mkvesala/VEDirect-ESP32-SignalK-gateway/README.md

# VEDirect-ESP32-SignalK Gateway








## Disclaimer

This is a personal hobby project. It is provided "as is", without warranty of any kind. See LICENSE.

This firmware is NOT intended for navigation or for any safety-critical use at sea. Do not rely on the data it produces (such as heading, depth or position) to navigate a vessel. Always use certified navigation equipment and proper seamanship.

You use this code entirely at your own risk. The author accepts no liability for any damage, injury or loss arising from its use.

## Introduction

ESP32-based gateway that reads battery data from a [Victron SmartShunt](https://www.victronenergy.com/battery-monitors/smart-battery-shunt) via the VE.Direct text protocol and forwards it to a [SignalK](https://signalk.org) server via WebSocket/JSON and to other ESP32 devices via ESP-NOW.

Reads five values from the SmartShunt: house battery voltage, current and power, state of charge, and starter battery voltage. Converts raw VE.Direct integers to SI units (V, A, W, SoC as percent) and sends all five values in a single SignalK delta every second.

Uses LCD 16x2 to show battery status, performance diagnostics and network connection info. If no Wi-Fi is available, ESP-NOW broadcast continues and the LCD shows battery data.

OTA updates enabled. Persistent configuration storage (NVS) and web UI reserved for future implementations.

Developed and tested on:
- [Wemos D1 R32 ESP32 development board](https://partco.fi/tuote/arduino-esp32-kehityskortti-esp-wroom-32-2526)
- [ESP32 board package](https://github.com/espressif/arduino-esp32) (3.3.8)
- [Arduino IDE](https://www.arduino.cc/en/software/) (2.3.8)
- SignalK Server (2.26.0)
- Victron SmartShunt (300 A)

Integrated via ESP-NOW to:
- [ESP32-Crowpanel-compass multi-function display](https://github.com/mkvesala/ESP32-Crowpanel-compass) v4.0.0

## Purpose of the project

This is one of my individual digital boat projects. Use at your own risk. Not for safety-critical operations.

1. I wanted a cost-effective way to get Victron battery monitor data wirelessly into SignalK without the official Victron dongle
2. I needed ESP-NOW output so a standalone display can show battery status without depending on the SignalK network being up
3. The project started as a single-file Arduino sketch and was later refactored into the class-based architecture I have used in my other "gateway" projects

## Release history

| Release | Branch | Comment |
|---|---|---|
| v1.2.4 | main | WiFi outage recovery: the radio stays on, so ESP-NOW keeps broadcasting while the router is down, and WiFi and SignalK reconnect by themselves. See CHANGELOG. |
| v1.2.3 | main | Shared `espnow_protocol.h` synced with the fleet-wide copy — adds `HALMET_OIL_DELTA` (10) and its `HALMETOilDelta` payload struct. Wire format of this gateway unchanged. |
| v1.2.2 | main | Documentation only — Disclaimer section added to README, fleet-wide `espnow_protocol.h` paragraph removed. |
| v1.2.1 | main | Shared `espnow_protocol.h` updated to the fleet-wide superset — adds `HALMET_WATER_DELTA` (7) and `DEPTH_DELTA` (8) with their payload structs, documents the shared-header rules and `msg_type` allocation, and fixes receiver-side GNSS conversion that hid position and SOG at anchor. Wire format of this gateway unchanged. |
| v1.2.0 | main | `SignalKBroker` owns the `WebsocketsClient` via `std::unique_ptr` and builds a fresh client on every reconnect — fixes a rare permanent WebSocket reconnect failure after long uptime where a stuck lwIP socket was reused indefinitely. |
| v1.1.0 | main | AP interface secured (hidden SSID, WPA2, intrusion detection). Wi-Fi timeout extended to 3 min, static IP support and hardened reconnect/recovery added. Active WebSocket ping/pong liveness with graceful transport-only reconnect. GNSS structs added to shared ESP-NOW protocol. |
| v1.0.0 | main | First versioned release. Full refactor into class-based architecture. ESP-NOW added. |

## Classes

Class diagram including the companion projects:



### VEDSensor

Encapsulates VE.Direct serial communication. Runs a FreeRTOS reader task pinned to Core 0 that continuously reads the UART stream and populates an internal cache protected by `portMUX_TYPE` spinlock. The main loop reads a consistent snapshot via `getSnapshot()` without blocking.

| Method | Returns | Comment |
|---|---|---|
| `begin()` | `void` | Configures UART2 (RX GPIO16, 19200 baud) and starts reader task. |
| `getSnapshot(Snapshot &out)` | `void` | Thread-safe atomic copy of the current cache. |
| `getReaderStackWatermark()` | `uint32_t` | Get stack high watermark of reader task. |

`VEDSensor::Snapshot` fields: `mv`, `ma`, `w`, `soc`, `vs` (raw int32) and matching millisecond timestamps `ts_mv` … `ts_vs`.

### VEDProcessor

Consumes a `VEDSensor::Snapshot`, converts raw VE.Direct integers to SI units, and populates the shared `ESPNow::BatteryDelta` struct. A value is set to `NaN` if its timestamp is older than 30 seconds.

| Method | Returns | Comment |
|---|---|---|
| `update()` | `void` | Reads snapshot, converts, updates delta and getters |
| `getDelta()` | `ESPNow::BatteryDelta` | All five SI values for brokers |
| `getHouseVoltage()` | `float` | House bank volts (V) |
| `getHouseCurrent()` | `float` | House bank amps (A) |
| `getHousePower()` | `float` | House bank watts (W) |
| `getHouseSoc()` | `float` | House bank state of charge (% 0.0-100.0) |
| `getStartVoltage()` | `float` | Starter battery volts (V) |
| `hasValidData()` | `bool` | True if at least one value is not NaN |

### Other classes

**`SignalKBroker`:**
- Owns: `WebsocketsClient` via `std::unique_ptr` — a fresh client is built on every reconnect and destroyed on teardown, so no stuck lwIP socket survives to the next attempt
- Uses: `VEDProcessor`
- Owned by: `VEDApplication`
- Responsible for: WebSocket connection to SignalK server, building and sending a single JSON delta containing all five battery values every ~1 s

**`ESPNowBroker`:**
- Uses: `VEDProcessor`
- Owned by: `VEDApplication`
- Responsible for: ESP-NOW broadcast of `ESPNowPacket<BatteryDelta>` every ~1 s using the shared `espnow_protocol.h` packet format

**`DisplayManager`:**
- Owns: two `LiquidCrystal_I2C` instances (addresses 0x27 and 0x3F), selected by I2C scan on boot
- Uses: `VEDProcessor`
- Owned by: `VEDApplication`
- Responsible for: LCD display of battery data, diagnostics and status messages

**`VEDPreferences`:**
- Uses: `VEDProcessor`
- Owned by: `VEDApplication`
- Responsible for: NVS configuration storage — *skeleton, not yet implemented*

**`WebUIManager`:**
- Uses: `VEDProcessor`, `VEDPreferences`, `SignalKBroker`, `DisplayManager`
- Owned by: `VEDApplication`
- Responsible for: HTTP configuration UI — *skeleton, not yet implemented*

**`VEDApplication`:**
- Owns: all subsystems as stack-allocated members
- Uses: `WifiState`
- Responsible for: orchestrating all subsystems, running the Wi-Fi state machine and timed loop handlers, AP interface security (hidden SSID, WPA2, intrusion detection and deauth)

**`WifiState`:**
- Global enum class for Wi-Fi connection states (INIT / CONNECTING / CONNECTED / FAILED / DISCONNECTED / OFF) just to lessen the amount of calls to WiFi library and to keep WiFi dependency only in `VEDApplication`

## Features

### VE.Direct reading

1. Reads the continuous VE.Direct text stream on UART2 (RX GPIO16, 19200 baud, SERIAL_8N1)
2. Reader runs in a dedicated FreeRTOS task on Core 0 at priority 2, independent of the main loop
3. Parsed label→value pairs are cached with millisecond timestamps; five labels tracked: `V`, `I`, `P`, `SOC`, `VS`
4. Cache access is protected by `portMUX_TYPE` spinlock's critical section; main loop reads via atomic `getSnapshot()`
5. Values older than 30 seconds are treated as stale and reported as `NaN`
6. Raw integers converted to SI units in `VEDProcessor`: mV→V, mA→A, Victron SoC tenths-of-percent→percent (0.0-100.0)

### SignalK communication

Connects to:
```
ws://<server>:<port>/signalk/v1/stream?token=<optional>
```

**Sends** at ~1 s interval, all five values in a single delta message:

1. `electrical.batteries.house.voltage` (V)
2. `electrical.batteries.house.current` (A)
3. `electrical.batteries.house.power` (W)
4. `electrical.batteries.house.capacity.stateOfCharge` (0.0-1.0)
5. `electrical.batteries.start.voltage` (V)

Values that are `NaN` (stale or not yet received) are silently omitted from the delta. If all five are `NaN` the delta is not sent.

WebSocket reconnection uses exponential backoff starting at ~2 s, doubling on each failed attempt up to a maximum of ~120 s. On successful reconnect the backoff resets to ~2 s. Each reconnect builds a **brand-new** WebSocket client (`SignalKBroker` owns it via `std::unique_ptr`) and destroys it on teardown, so a socket that has stuck in an unrecoverable state is never reused — freeing the underlying lwIP socket guarantees every attempt starts from a clean transport. This prevents a rare permanent reconnect failure observed after long uptime (~12–48 h) where a reused client could no longer connect until a manual reboot.

**Connection liveness (active ping/pong):** while the socket is open the device sends a WebSocket ping every ~10 s and tracks the server's pong. If no pong arrives within ~30 s the connection is considered dead — even when `isOpen()` still reports `true`, as happens with a half-open TCP connection (e.g. the SignalK host freezing the link under power-saving) — and the socket is closed so the exponential back-off reconnects it. Recovery is transport-only: the device does **not** reboot, so ESP-NOW, the LCD and uptime are unaffected.

Each Wi-Fi connection attempt lasts up to ~15 s. If it fails, the device keeps running with ESP-NOW only and retries every ~30 s–2 min (exponential back-off) until the network returns; SignalK and OTA resume without a reboot. The radio is never switched off, and while waiting it is held on ESP-NOW channel 6.

The device connects with a static IP address configured via `WiFi.config()` from `WIFI_STATIC_IP` / `WIFI_GATEWAY` / `WIFI_SUBNET` in `secrets.h`, rather than relying on the router's DHCP lease table — keep the chosen address outside the router's DHCP pool. If Wi-Fi drops, the connection is rebuilt with a hard reset (`WiFi.disconnect(true)` + reapplied static IP and sleep settings) and the SignalK WebSocket is reopened automatically.

**Please refer to Security section of this file.**

### ESP-NOW communication

Broadcasts battery data via ESP-NOW protocol for other ESP32 devices such as external displays. Operates independently of Wi-Fi — broadcast continues even if SignalK connection is lost.

All ESP-NOW messages use the shared `ESPNow::ESPNowPacket` wrapper (`ESPNowHeader` + typed payload) defined in `espnow_protocol.h`.

**Sends** at ~1 s interval:
- `ESPNow::ESPNowPacket<BatteryDelta>` — payload `BatteryDelta` containing:
  - `house_voltage` (V)
  - `house_current` (A)
  - `house_power` (W)
  - `house_soc` (% 0.0-100.0)
  - `start_voltage` (V)

**Broadcast mode:** Uses broadcast address (FF:FF:FF:FF:FF:FF) — any ESP-NOW receiver on the same Wi-Fi channel can listen.

**WiFi coexistence:** ESP-NOW operates alongside Wi-Fi (`WIFI_AP_STA` mode). Both SignalK WebSocket and ESP-NOW broadcast function simultaneously. The AP interface required by `WIFI_AP_STA` is secured — see Security section.

**Note: ESP-NOW receivers must be on the same Wi-Fi channel as this device. The simplest approach is to connect both devices to the same Wi-Fi network with a fixed channel.**

### LCD 16x2

1. Shows house voltage, starter voltage, house current and state of charge in a compact two-line layout:
   ```
    26.54V  26.71V
    -3.20A  87.5%
   ```
2. Shows status messages during boot (Wi-Fi connecting, IP address, signal level) and periodically during operation (Wi-Fi signal level, WebSocket open/closed)
3. Shows diagnostic messages on the way (free heap mem, stack high watermark for reader task and main loop)
4. LCD content refreshes only when it has changed, to avoid unnecessary blinking
5. Supports both I2C addresses 0x27 and 0x3F — detected automatically on boot
6. If no LCD is detected the device operates normally without display output

Using a different display can be done within `DisplayManager` while keeping its public API intact.

## Project structure

| File(s) | Description |
|---|---|
| `VEDirect-ESP32-SignalK-gateway.ino` | Owns `VEDApplication app`, contains `setup()` and `loop()` |
| `secrets.example.h` | Example credentials. Rename to `secrets.h` and populate with your credentials |
| `version.h` | Software version constant |
| `helpers.h` | Global helper functions |
| `espnow_protocol.h` | Shared ESP-NOW protocol definitions (header, payload structs, packet wrapper) — fleet-wide superset, kept byte-identical in every project |
| `WifiState.h` | Enum class for Wi-Fi states |
| `VEDSensor.h / .cpp` | Class `VEDSensor` — VE.Direct UART reader, FreeRTOS task, thread-safe cache |
| `VEDProcessor.h / .cpp` | Class `VEDProcessor` — unit conversion and `BatteryDelta` assembly |
| `VEDPreferences.h / .cpp` | Class `VEDPreferences` — NVS storage skeleton |
| `SignalKBroker.h / .cpp` | Class `SignalKBroker` — WebSocket connection and delta sender |
| `ESPNowBroker.h / .cpp` | Class `ESPNowBroker` — ESP-NOW broadcast sender |
| `DisplayManager.h / .cpp` | Class `DisplayManager` — LCD 16x2 I2C control |
| `WebUIManager.h / .cpp` | Class `WebUIManager` — HTTP web UI skeleton |
| `VEDApplication.h / .cpp` | Class `VEDApplication` — application orchestrator |

## Hardware

### Bill of materials

1. Wemos D1 R32 ESP32 Dev Module
2. Victron SmartShunt with VE.Direct port
3. LCD 16x2 module with I2C backpack
4. Wi-Fi router providing wireless LAN AP with a fixed channel
5. 3D printed [panel mount bezel](https://www.printables.com/model/158413-panel-mount-16x2-lcd-bezel) for LCD 16x2
6. Wiring, DC power jack, enclosure
7. MacOS device running SignalK server in LAN
8. Crowpanel 2.1" HMI rotary display running Crowpanel-ESP32-compass firmware

### Wiring

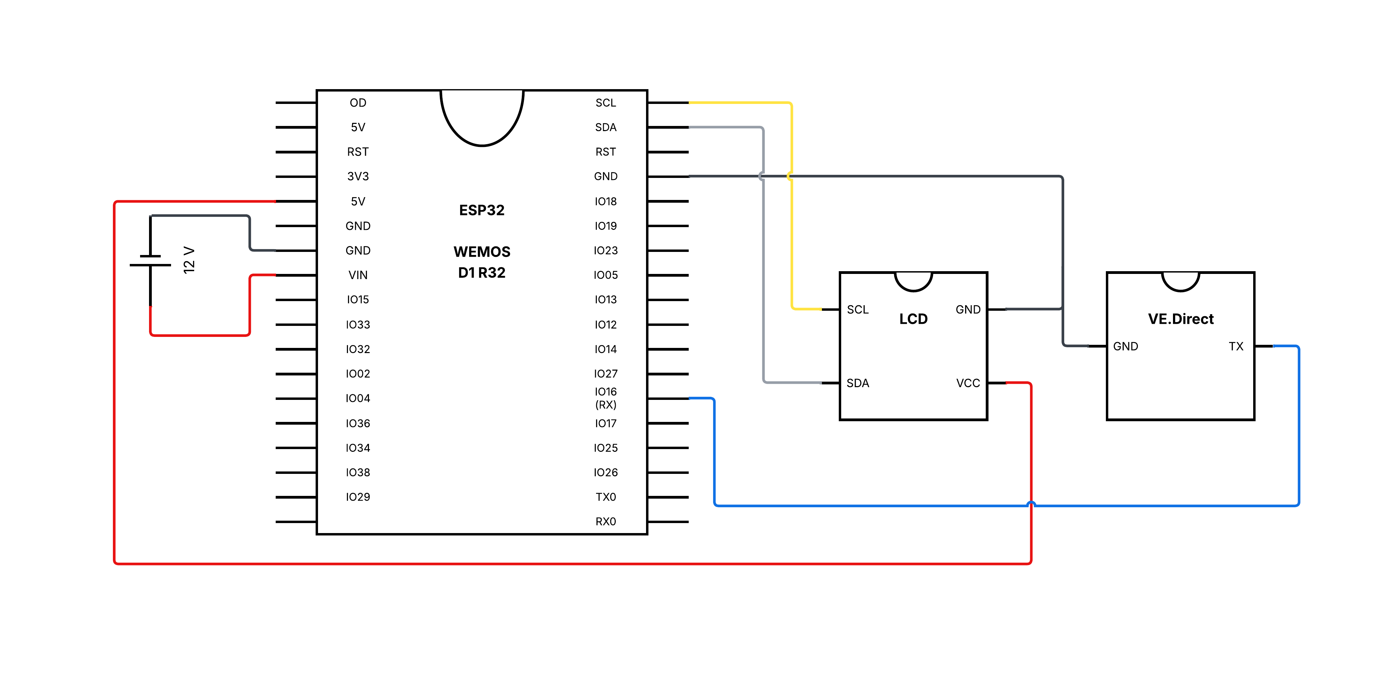
[picture p1: docs/vedschema.png]


**Note: Victron SmartShunt versions use both 3.3 V and 5 V TTL levels at VE.Direct port — ALWAYS measure the level before connecting to ESP32 board and use logic level shifter if needed!**

**No paid partnerships.**

## Software used

1. Arduino IDE 2.3.8
2. Espressif Systems esp32 board package 3.3.8
3. Additional libraries installed via Library Manager:
   - ArduinoWebsockets by Gil Maimon (0.5.4)
   - ArduinoJson by Benoit Blanchon (7.4.3)
   - LiquidCrystal_I2C by Frank de Brabander (1.1.2)
   - ArduinoOTA (included in ESP32 board package)
4. Crowpanel-ESP32-compass firmware (v4.0.0)
5. SignalK server (2.26.0)

## Installation

1. Clone the repo
   ```
   git clone https://github.com/mkvesala/VEDirect-ESP32-SignalK-gateway.git
   ```
2. Alternatively, download the code as a zip
3. Set up your credentials in `secrets.h` (first by renaming `secrets.example.h` to `secrets.h`)
   ```cpp
   inline constexpr const char* WIFI_SSID            = "your_wifi_ssid_here";
   inline constexpr const char* WIFI_PASS            = "your_wifi_password_here";
   inline constexpr const char* WIFI_STATIC_IP       = "192.168.1.50";   // keep outside the router's DHCP pool
   inline constexpr const char* WIFI_GATEWAY         = "192.168.1.1";
   inline constexpr const char* WIFI_SUBNET          = "255.255.255.0";
   inline constexpr const char* SK_HOST              = "your_signalk_address_here";
   inline constexpr uint16_t    SK_PORT              = 3000; // or whatever your port is
   inline constexpr const char* SK_TOKEN             = "your_token_here";
   inline constexpr const char* OTA_PASS             = "your_ota_password_here";
   inline constexpr const char* DEFAULT_WEB_PASSWORD = "your_default_web_password_here";
   inline constexpr const char* AP_SSID              = "your_ap_ssid_here";    // hidden, name not critical
   inline constexpr const char* AP_PASS              = "your_ap_password_here"; // min 8 chars (WPA2)
   ```
4. **Make sure that `secrets.h` is listed in your `.gitignore` file**
5. Connect the SmartShunt VE.Direct TX to GPIO16 (RX) and optionally an LCD to the I2C pins
6. Connect and power up the ESP32 via USB
7. Compile and upload with Arduino IDE (board package and required libraries installed)
8. Open Serial Monitor at 115200 baud to verify the device is reading VE.Direct data and connecting to Wi-Fi
9. Verify battery values appear in the SignalK server data browser

**Please refer to Security section of this file.**

## Todo

Check [issues](https://github.com/mkvesala/VEDirect-ESP32-SignalK-gateway/issues).

## Security

### Maritime navigation

**Use at your own risk — not for safety-critical operations!**

### Current state

The web UI is not yet implemented — there are no HTTP endpoints exposed. The device only opens an outbound WebSocket connection to the SignalK server and sends ESP-NOW broadcasts.

### AP interface

`WIFI_AP_STA` mode is required for ESP-NOW and Wi-Fi to operate simultaneously. This opens an AP interface on the ESP32 that is not intended for external connections. It is hardened with three lines of defence:

| Line | Mechanism |
|---|---|
| **1. Hidden SSID** | `ssid_hidden=1` — the network is not advertised |
| **2. WPA2 password** | `AP_PASS` from `secrets.h` (min 8 characters) — connection is blocked without the password |
| **3. Immediate deauth + alert** | If a client connects despite the above, it is kicked immediately via `esp_wifi_deauth_sta()` in the WiFi event callback. The MAC address is logged to Serial and shown on the LCD. |

Set `AP_SSID` and `AP_PASS` in `secrets.h`. The SSID name is not critical since it is hidden — use something non-identifying. The password must be at least 8 characters (WPA2 requirement).

### SignalK token

If your SignalK server requires authentication, provide the token in `secrets.h`. The token is transmitted in the WebSocket URL in plaintext over the local network.

### Important security considerations

1. **No HTTPS**
   - WebSocket connection transmits data in plaintext
   - Use only on private, trusted networks

2. **LAN deployment only**
   - Do NOT expose the device to the public internet
   - Keep the ESP32 on an isolated boat Wi-Fi network
   - Use WPA2/WPA3 encryption

3. **`secrets.h`**
   - Make sure that `secrets.h` is listed in your `.gitignore` file
   - Never commit credentials to version control

### Deployment

**Recommended:**
- Deploy on a private isolated boat Wi-Fi
- Use WPA2/WPA3 Wi-Fi encryption

**Not recommended:**
- Public internet exposure
- Port forwarding to the ESP32

## Credits

Software and libraries used are described in the above sections.

Inspired by [VictronVEDirectArduino](https://github.com/winginitau/VictronVEDirectArduino) library.

This project started as a single-file `.ino` sketch and was refactored into the class-based architecture, which also serves as the architectural reference for [CMPS14-ESP32-SignalK-gateway](https://github.com/mkvesala/CMPS14-ESP32-SignalK-gateway), [UBLOX-ESP32-SignalK-gateway](https://github.com/mkvesala/UBLOX-ESP32-SignalK-gateway), [HALMET-ESP32-SignalK-gateway](https://github.com/mkvesala/HALMET-ESP32-SignalK-gateway) and [BME280-ESP32-SignalK-gateway](https://github.com/mkvesala/BME280-ESP32-SignalK-gateway). This is a companion project also to the [ESP32-Crowpanel-compass](https://github.com/mkvesala/ESP32-Crowpanel-compass). See below diagram how the projects relate:



No paid partnerships.

Developed by Matti Vesala in collaboration with Claude Code. See [CONTRIBUTING](CONTRIBUTING.md) for guidelines on development.

I would appreciate improvement suggestions as well as any Arduino-style ESP32/C++ coding advice.

## Gallery

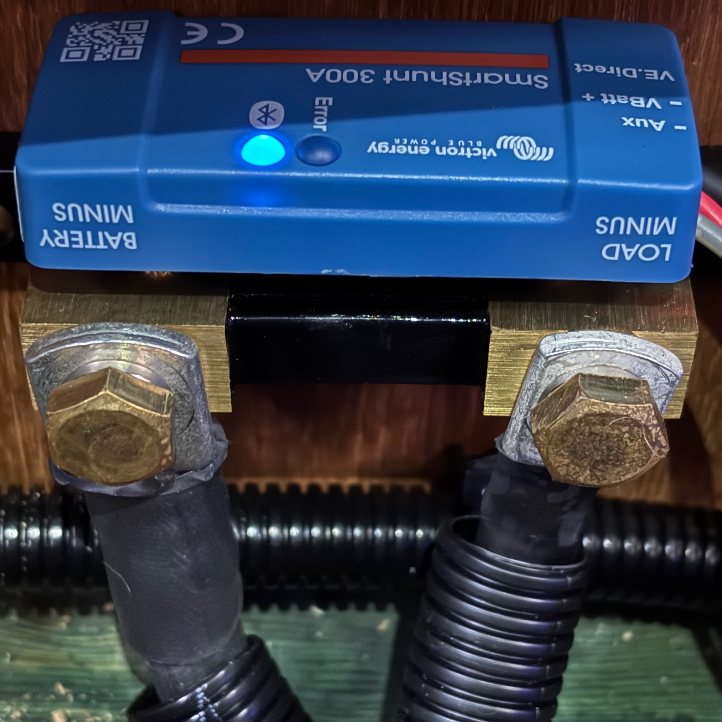
[picture p2: docs/shunt.jpeg]
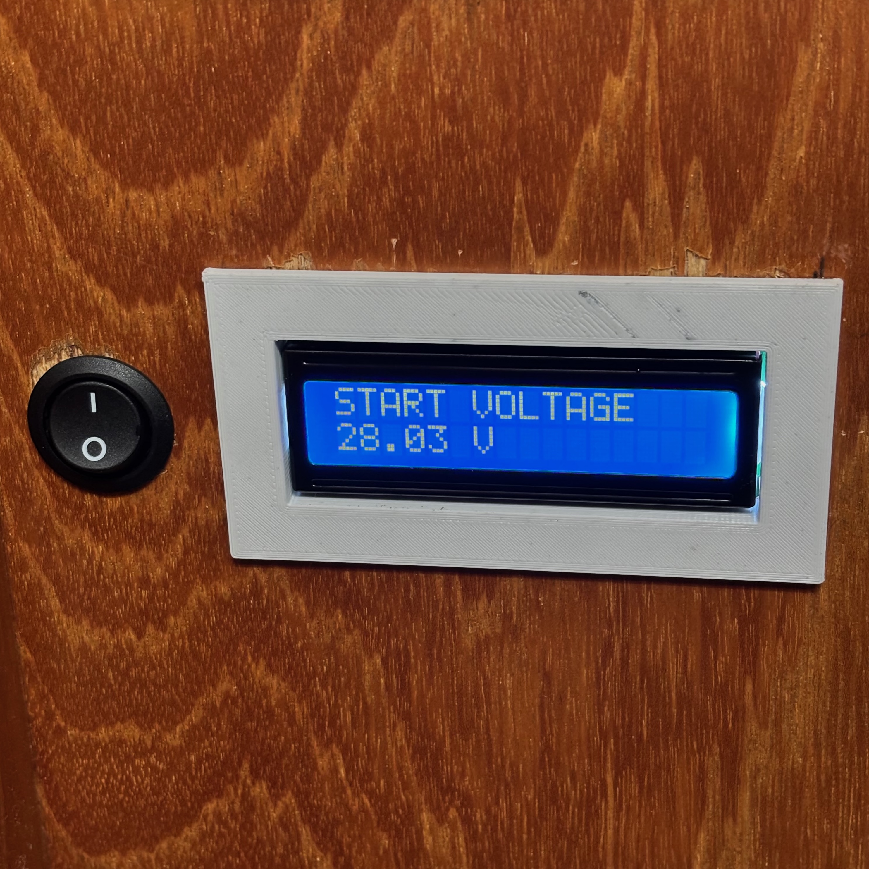
[picture p3: docs/lcd.jpeg]
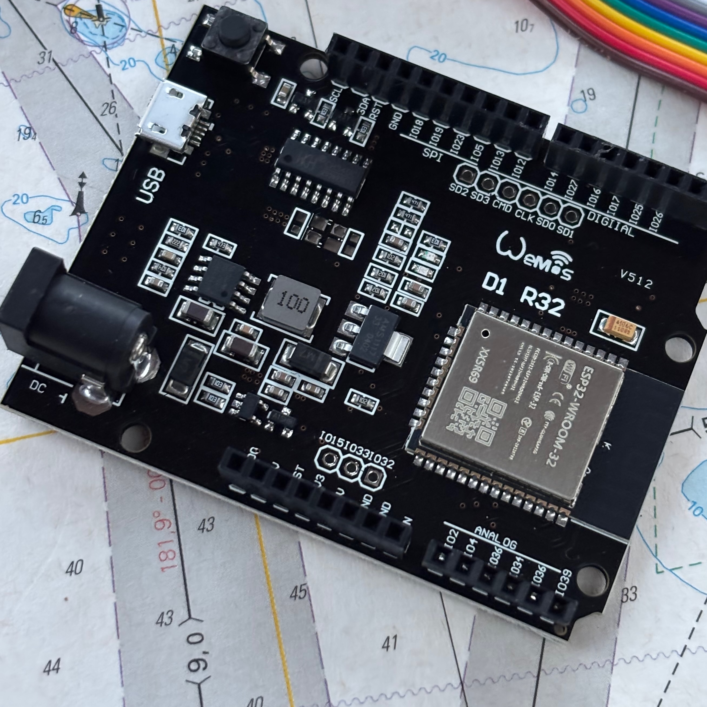
[picture p4: docs/wemos.jpeg]
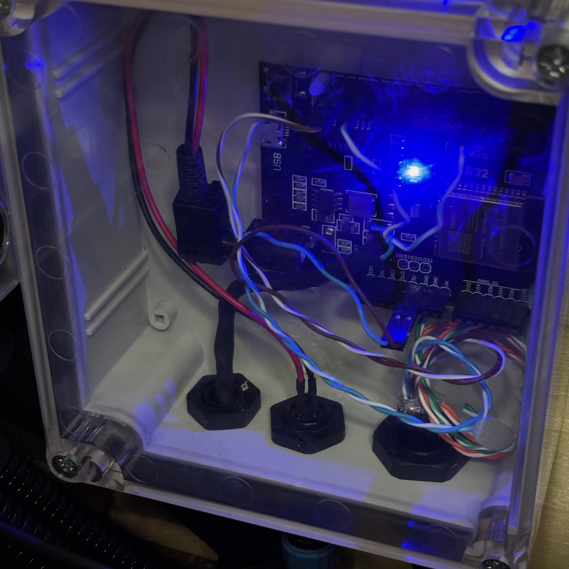
[picture p5: docs/enclosure.jpeg]
