mkvesala/VEDirect-ESP32-SignalK-gateway/VEDSensor.cpp

#include "VEDSensor.h"

// === S T A T I C ===

static HardwareSerial s_ved_serial(2);

// === P U B L I C ===

// Constructor
VEDSensor::VEDSensor()
    : _spinlock(portMUX_INITIALIZER_UNLOCKED)
    , _cache()
{}

// Initialise, sensor read on core 0
void VEDSensor::begin() {

    s_ved_serial.setRxBufferSize(RX_BUF);
    s_ved_serial.begin(VE_BAUD, SERIAL_8N1, RX_PIN, TX_PIN);
    xTaskCreatePinnedToCore(readerTask, "vedread", 4096, this, 2, &_reader_task_handle, 0);

}

// Reader task stack high water mark in bytes (ESP-IDF FreeRTOS, not vanilla FreeRTOS words)
uint32_t VEDSensor::getReaderStackWatermark() const {
    if (!_reader_task_handle) return 0;
    return (uint32_t)uxTaskGetStackHighWaterMark(_reader_task_handle);
}

// Get thread safe snapshot of sensor data
void VEDSensor::getSnapshot(Snapshot& out) const {
    portENTER_CRITICAL(&_spinlock);
    out = _cache;
    portEXIT_CRITICAL(&_spinlock);
}

// Cache value
void VEDSensor::cacheSet(volatile int32_t& slot, volatile uint32_t& ts, int32_t v) {
    portENTER_CRITICAL(&_spinlock);
    slot = v;
    ts = millis();
    portEXIT_CRITICAL(&_spinlock);
}

// FreeRTOS task for core 0
void VEDSensor::readerTask(void* pvParameters) {
    static_cast<VEDSensor*>(pvParameters)->runReaderLoop();
}

// Reader loop for FreeRTOS task
void VEDSensor::runReaderLoop() {
    char line[LINE_SIZE];
    size_t idx = 0;

    for (;;) {
        if (!s_ved_serial.available()) {
            vTaskDelay(1);
            continue;
        }

        int b = s_ved_serial.read();
        if (b < 0) { vTaskDelay(1); continue; }
        if (b == '\r') continue;

        if (b == '\n') {
            line[idx] = '\0';
            idx = 0;

            char* save  = nullptr;
            char* label = strtok_r(line, "\t", &save);
            if (!label || !*label) { vTaskDelay(1); continue; }
            char* val   = strtok_r(nullptr, "\t", &save);
            if (!val || !*val) { vTaskDelay(1); continue; }

            long v;
            if (val[0] == 'O') v = (val[1] == 'N') ? 1 : 0;
            else v = strtol(val, nullptr, 10);

            if      (strcmp(label, "V")   == 0) cacheSet(_cache.mv,  _cache.ts_mv,  (int32_t)v);
            else if (strcmp(label, "I")   == 0) cacheSet(_cache.ma,  _cache.ts_ma,  (int32_t)v);
            else if (strcmp(label, "P")   == 0) cacheSet(_cache.w,   _cache.ts_w,   (int32_t)v);
            else if (strcmp(label, "SOC") == 0) cacheSet(_cache.soc, _cache.ts_soc, (int32_t)v);
            else if (strcmp(label, "VS")  == 0) cacheSet(_cache.vs,  _cache.ts_vs,  (int32_t)v);

        } else {
            if (idx + 1 < LINE_SIZE) {
                line[idx++] = (char)b;
            } else {
                while (s_ved_serial.available()) {
                    int bb = s_ved_serial.read();
                    if (bb == '\n' || bb < 0) break;
                }
                idx = 0;
            }
        }
    }
}
