mkvesala/VEDirect-ESP32-SignalK-gateway/VEDApplication.cpp

#include "VEDApplication.h"
#include "secrets.h"

// === P U B L I C ===

// Constructor
VEDApplication::VEDApplication()
    : _sensor()
    , _processor(_sensor)
    , _prefs(_processor)
    , _signalk(_processor)
    , _espnow(_processor)
    , _display(_processor)
    , _webui(_processor, _prefs, _signalk, _display)
{}

// Initialize
void VEDApplication::begin() {
 
    // I2C
    Wire.begin(I2C_SDA, I2C_SCL);
    delay(47);

    // LCD
    _display.begin();
    _display.showMessage("STARTING...", "INIT WIFI...");

    // Not needed
    btStop();

    //  WiFi AP_STA — required for WiFi / ESP-NOW coexistence.
    //  softAP() secures the AP interface immediately after mode() — before any
    //  client can connect. Hidden SSID, WPA2 password, max 1 connection.
    WiFi.mode(WIFI_AP_STA);
    WiFi.softAP(AP_SSID, AP_PASS, ESPNOW_CHANNEL, 1 /*ssid_hidden*/, 1 /*max_connection*/);
    this->applyStaticIP();

    // 3rd line of AP defence — registered before WiFi.begin() so no event is missed.
    // Callback runs in the FreeRTOS "arduino_events" task: deauth immediately, flag loop().
    // MAC is copied before setting the flag so loop() always reads a complete address.
    WiFi.onEvent([this](arduino_event_id_t /*id*/, arduino_event_info_t info) {
        uint8_t aid = info.wifi_ap_staconnected.aid;
        memcpy(_ap_intruder_mac, info.wifi_ap_staconnected.mac, 6);
        esp_wifi_deauth_sta(aid);  // kick immediately — ESP-IDF call, thread-safe
        _ap_intruder = true;       // signal loop()
    }, ARDUINO_EVENT_WIFI_AP_STACONNECTED);

    WiFi.setSleep(false);
    WiFi.setAutoReconnect(false);   // handleWifi() is the only reconnect logic — no background scans
    WiFi.begin(WIFI_SSID, WIFI_PASS);
    _wifi_state = WifiState::CONNECTING;
    _wifi_conn_start_ms = millis();
    _display.showMessage("WIFI", "CONNECT...");

    // ESP-NOW
    _espnow.begin();

    // Sensor - runs on Core 0
    _sensor.begin();
}

// Loop
void VEDApplication::loop() {

    const unsigned long now = millis();

    this->handleWifi(now);
    this->handleAPIntruder();
    this->handleOTA();
    this->handleWebUI();
    this->handleWebsocket(now);
    this->handleSensorRead(now);
    this->handleSignalK(now);
    this->handleESPNow(now);
    this->handleDisplay(now);

}

// === P R I V A T E ===

// WiFi state machine
void VEDApplication::handleWifi(unsigned long now) {

    if ((long)(now - _wifi_last_check_ms) < (long)WIFI_STATUS_CHECK_MS) return;
    _wifi_last_check_ms = now;

    switch (_wifi_state) {
        case WifiState::INIT:
            break;

        case WifiState::CONNECTING: {
            wl_status_t status = WiFi.status();
            if (status == WL_CONNECTED) {
                _wifi_state = WifiState::CONNECTED;
                _wifi_retry_ms = WIFI_RETRY_MS;
                this->initWifiServices();
                _expn_retry_ms  = WS_RETRY_MS;
                _next_ws_try_ms = now;
            } else if ((long)(now - _wifi_conn_start_ms) >= (long)WIFI_TIMEOUT_MS) {
                // Timeout only — WL_NO_SSID_AVAIL / WL_CONNECT_FAILED may be stale right after begin()
                this->enterWifiWait(now);
                _display.showMessage("NO WIFI", "ESP-NOW ONLY");
            }
            break;
        }

        case WifiState::CONNECTED: {
            if (!WiFi.isConnected()) {
                _signalk.closeWebsocket();
                _wifi_state = WifiState::CONNECTING;
                WiFi.disconnect(true);
                delay(200);
                WiFi.setSleep(false);
                this->applyStaticIP();
                WiFi.begin(WIFI_SSID, WIFI_PASS);
                _wifi_conn_start_ms = now;
            }
            break;
        }

        case WifiState::DISCONNECTED: {
            // STA idle, radio on — hold the ESP-NOW channel until the next retry
            uint8_t primary = 0;
            wifi_second_chan_t second = WIFI_SECOND_CHAN_NONE;
            if (esp_wifi_get_channel(&primary, &second) == ESP_OK && primary != ESPNOW_CHANNEL) {
                esp_wifi_set_channel(ESPNOW_CHANNEL, WIFI_SECOND_CHAN_NONE);
            }
            if ((long)(now - _wifi_next_retry_ms) >= 0) {
                _wifi_state = WifiState::CONNECTING;
                WiFi.setSleep(false);        // reapply before every WiFi.begin()
                this->applyStaticIP();       // reapply before every WiFi.begin()
                WiFi.begin(WIFI_SSID, WIFI_PASS);
                _wifi_conn_start_ms = now;
            }
            break;
        }

        case WifiState::FAILED:
        case WifiState::OFF:
            break;
    }
}

// Stop the connect attempt, keep the radio on for ESP-NOW and schedule the next retry
void VEDApplication::enterWifiWait(unsigned long now) {
    WiFi.disconnect();   // STA idle only — never disconnect(true) or WiFi.mode(WIFI_OFF) here
    _wifi_state = WifiState::DISCONNECTED;
    _wifi_next_retry_ms = now + _wifi_retry_ms;
    _wifi_retry_ms = min(_wifi_retry_ms * 2, WIFI_RETRY_MAX_MS);
}

// Static IP — must be (re)applied after every WiFi.mode()/disconnect(true), before WiFi.begin()
void VEDApplication::applyStaticIP() {
    IPAddress ip, gateway, subnet;
    ip.fromString(WIFI_STATIC_IP);
    gateway.fromString(WIFI_GATEWAY);
    subnet.fromString(WIFI_SUBNET);
    if (!WiFi.config(ip, gateway, subnet, gateway)) {
        Serial.println("[WIFI] static IP config failed — falling back to DHCP");
    }
}

// WiFi dependent stuff — guarded so OTA and WebServer routes are registered exactly once
void VEDApplication::initWifiServices() {
    if (_wifi_services_initialized) return;
    _wifi_services_initialized = true;

    _signalk.begin();

    ArduinoOTA.setHostname(_signalk.getSignalKSource());
    ArduinoOTA.setPassword(OTA_PASS);
    ArduinoOTA.onStart([](){});
    ArduinoOTA.onEnd([](){});
    ArduinoOTA.onProgress([](unsigned int progress, unsigned int total){});
    ArduinoOTA.onError([](ota_error_t error){});
    ArduinoOTA.begin();

    _webui.begin();

    // Show IP address
    char ip_str[16];
    IPAddress ip = WiFi.localIP();
    snprintf(ip_str, sizeof(ip_str), "%d.%d.%d.%d", ip[0], ip[1], ip[2], ip[3]);
    _display.showMessage("WIFI OK", ip_str);
    delay(2000);

    // Show RSSI
    char rssi_str[17];
    snprintf(rssi_str, sizeof(rssi_str), "SIG: %s", rssiLabel(WiFi.RSSI()));
    _display.showMessage("SIGNAL LEVEL:", rssi_str);
    delay(2000);

}

// AP intruder alert — deauth already done in event callback; log + display here
void VEDApplication::handleAPIntruder() {
    if (!_ap_intruder) return;
    _ap_intruder = false;  // clear before Serial/display so a rapid second event isn't lost
    char mac[18];
    snprintf(mac, sizeof(mac), "%02X:%02X:%02X:%02X:%02X:%02X",
             _ap_intruder_mac[0], _ap_intruder_mac[1], _ap_intruder_mac[2],
             _ap_intruder_mac[3], _ap_intruder_mac[4], _ap_intruder_mac[5]);
    Serial.printf("[AP] INTRUDER deauthed — MAC %s\n", mac);
    _display.showMessage("AP: INTRUDER!", mac);
}

// OTA
void VEDApplication::handleOTA() {
    if (_wifi_state != WifiState::CONNECTED) return;
    ArduinoOTA.handle();
}

// WebUI
void VEDApplication::handleWebUI() {
    if (_wifi_state != WifiState::CONNECTED) return;
    _webui.handleRequest();
}

// Websocket
void VEDApplication::handleWebsocket(unsigned long now) {
    if (_wifi_state != WifiState::CONNECTED) return;
    _signalk.handleStatus();   // poll() — also delivers the GotPong event that feeds isStale()

    if (_signalk.isOpen()) {
        _expn_retry_ms = WS_RETRY_MS;
        if ((long)(now - _last_ping_ms) >= (long)WS_PING_MS) {
            _signalk.ping();
            _last_ping_ms = now;
        }
        if (_signalk.isStale(now)) {     // half-open TCP: open but no pong within timeout
            _signalk.closeWebsocket();   // next iterations reconnect via existing backoff
        }
    } else if ((long)(now - _next_ws_try_ms) >= 0) {
        _signalk.connectWebsocket();
        _next_ws_try_ms = now + _expn_retry_ms;
        _expn_retry_ms  = min(_expn_retry_ms * 2, WS_RETRY_MAX_MS);
    }
}

// Read sensor
void VEDApplication::handleSensorRead(unsigned long now) {
    if ((long)(now - _last_read_ms) < (long)SENSOR_READ_MS) return;
    _last_read_ms = now;
    _processor.update();
}

// Send to SignalK
void VEDApplication::handleSignalK(unsigned long now) {
    if (_wifi_state != WifiState::CONNECTED) return;
    if ((long)(now - _last_tx_ms) < (long)TX_INTERVAL_MS) return;
    _last_tx_ms = now;
    _signalk.sendDelta();
}

// ESP-NOW broadcast
void VEDApplication::handleESPNow(unsigned long now) {
    _espnow.processIncomingCommands();
    if ((long)(now - _last_espnow_tx_ms) < (long)ESPNOW_TX_MS) return;
    _last_espnow_tx_ms = now;
    _espnow.sendDelta();
}

// Display messages on LCD
void VEDApplication::handleDisplay(unsigned long now) {
    if ((long)(now - _last_display_ms) < (long)DISPLAY_INTERVAL_MS) return;
    _last_display_ms = now;

    const uint8_t t = ++_display_tick_ctr;
    const uint8_t phase = t % DISPLAY_CYCLE;

    if (phase == 0) {
        // WiFi + WebSocket
        if (_wifi_state == WifiState::DISCONNECTED || _wifi_state == WifiState::OFF
            || _wifi_state == WifiState::FAILED) {
            _display.showMessage("NO WIFI", "ESP-NOW ONLY");
        } else if (_wifi_state == WifiState::CONNECTED) {
            char l1[17], l2[17];
            snprintf(l1, sizeof(l1), "WIFI %s", rssiLabel((int8_t)WiFi.RSSI()));
            snprintf(l2, sizeof(l2), "WS %s", _signalk.isOpen() ? "OPEN" : "CLOSED");
            _display.showMessage(l1, l2);
        } else {
            _display.showMessage("WIFI", "CONNECTING...");
        }
    } else if (phase == DISPLAY_CYCLE / 2) {
        // Diagnostics
        const uint32_t freeHeap   = ESP.getFreeHeap();
        const uint32_t mainWm     = (uint32_t)uxTaskGetStackHighWaterMark(NULL);
        const uint32_t readerWm   = _sensor.getReaderStackWatermark();
        _display.showDiagData(freeHeap, mainWm, readerWm);
    } else {
        _display.showBatteryData();
    }
}

// Helper for RSSI descriptor
const char* VEDApplication::rssiLabel(int8_t rssi) {
    if (rssi > -55) return "EXCELLENT";
    if (rssi < -80) return "POOR";
    return "OK";
}
