mkvesala/VEDirect-ESP32-SignalK-gateway/VEDApplication.h

#pragma once

#include <Arduino.h>
#include <Wire.h>
#include <WiFi.h>
#include <ArduinoOTA.h>
#include <esp_wifi.h>
#include "WifiState.h"
#include "VEDSensor.h"
#include "VEDProcessor.h"
#include "VEDPreferences.h"
#include "SignalKBroker.h"
#include "ESPNowBroker.h"
#include "DisplayManager.h"
#include "WebUIManager.h"

// === C L A S S  V E D A P P L I C A T I O N ===
//
// - Class VEDApplication - responsible for orchestrating everything
// - Init: app.begin();
// - Loop: app.loop();
// - Owns: VEDSensor, VEDProcessor, VEDPreferences, SignalKBroker, ESPNowBroker, DisplayManager, WebUIManager
// - Uses: WifiState

class VEDApplication {

public:

    explicit VEDApplication();

    void begin();
    void loop();

private:

    static constexpr uint8_t I2C_SDA = 21;
    static constexpr uint8_t I2C_SCL = 22;

    static constexpr unsigned long SENSOR_READ_MS       = 101;
    static constexpr unsigned long TX_INTERVAL_MS       = 499;
    static constexpr unsigned long DISPLAY_INTERVAL_MS  = 2003;
    static constexpr unsigned long WIFI_STATUS_CHECK_MS = 503;
    static constexpr unsigned long WIFI_TIMEOUT_MS      = 14983;   // One STA connect attempt (was 179999)
    static constexpr unsigned long WIFI_RETRY_MS        = 29989;   // First wait before a WiFi retry
    static constexpr unsigned long WIFI_RETRY_MAX_MS    = 119993;  // WiFi retry backoff ceiling
    // ESP-NOW channel — must equal the router's fixed WiFi channel and the receivers' channel
    static constexpr uint8_t ESPNOW_CHANNEL = 6;
    static constexpr unsigned long WS_RETRY_MS          = 1999;
    static constexpr unsigned long WS_RETRY_MAX_MS      = 119993;
    static constexpr unsigned long WS_PING_MS           = 9973;   // Client WebSocket ping cadence (~10 s) — liveness probe
    static constexpr unsigned long ESPNOW_TX_MS         = 991;
    static constexpr uint8_t       DISPLAY_CYCLE        = 30;

    bool          _wifi_services_initialized = false;

    unsigned long _last_read_ms       = 0;
    unsigned long _last_tx_ms         = 0;
    unsigned long _last_display_ms    = 0;
    unsigned long _last_espnow_tx_ms  = 0;
    unsigned long _wifi_conn_start_ms = 0;
    unsigned long _wifi_last_check_ms = 0;
    unsigned long _wifi_retry_ms      = WIFI_RETRY_MS;
    unsigned long _wifi_next_retry_ms = 0;
    unsigned long _next_ws_try_ms     = 0;
    unsigned long _expn_retry_ms      = WS_RETRY_MS;
    unsigned long _last_ping_ms       = 0;   // Liveness: last client ping sent
    uint8_t       _display_tick_ctr   = 0;

    WifiState _wifi_state = WifiState::INIT;

    // AP intruder detection — written in WiFi event callback, read in loop()
    volatile bool _ap_intruder        = false;
    uint8_t       _ap_intruder_mac[6] = {};

    VEDSensor _sensor;
    VEDProcessor _processor;
    VEDPreferences _prefs;
    SignalKBroker _signalk;
    ESPNowBroker _espnow;
    DisplayManager _display;
    WebUIManager _webui;

    void handleWifi(unsigned long now);
    void enterWifiWait(unsigned long now);
    void handleAPIntruder();
    void handleOTA();
    void handleWebUI();
    void handleWebsocket(unsigned long now);
    void handleSensorRead(unsigned long now);
    void handleSignalK(unsigned long now);
    void handleESPNow(unsigned long now);
    void handleDisplay(unsigned long now);

    void initWifiServices();
    void applyStaticIP();

    static const char* rssiLabel(int8_t rssi);
};
