mkvesala/VEDirect-ESP32-SignalK-gateway/WebUIManager.cpp

#include "WebUIManager.h"

// Constructor
WebUIManager::WebUIManager(
    VEDProcessor &processorRef,
    VEDPreferences &prefsRef,
    SignalKBroker &signalkRef,
    DisplayManager &displayRef
)
    : _processor(processorRef)
    , _prefs(prefsRef)
    , _signalk(signalkRef)
    , _display(displayRef)
    , _server(80)
{}
