mkvesala/VEDirect-ESP32-SignalK-gateway/(commit log)

2025-10-21 Initial commit of VEDirect-ESP32-SignalK-gateway.
2026-03-08 First refactored commit based on ESP32_gateway_pattern.md documentation
2026-04-01 Added .github templates, LICENSES.md and moved Wire.begin() to app.begin()
2026-04-01 Added project photos. Updated documentation. Fixed a delta unit issue with SoC -> % in ESPNow, ratio in SignalK
    [DisplayManager.cpp, SignalKBroker.cpp, VEDProcessor.cpp, VEDProcessor.h]
2026-04-06 Updating README with UML class diagram - master in ESP32-Crowpanel-compass repo
2026-04-09 Updated display update timer --> 2000 ms
2026-04-24 Refactor project references in README
    Updated project references in README to include UBLOX-ESP32-SignalK-gateway.
2026-05-09 Implemented WiFi reconnect issue fix and updated CHANGELOG accordingly.
    [VEDApplication.cpp, VEDApplication.h]
2026-06-06 Added wathdog for network freezing caused by macOS power saving at SignalK server side
2026-06-07 Revert "Added wathdog for network freezing caused by macOS power saving at SignalK server side"
    This reverts commit a2f656687bd160878d28e168d3be54a194957bf8.
    [VEDApplication.cpp, VEDApplication.h]
2026-07-04 Implemented websocket liveness (ping/pong) and graceful reconnect feature of ESP32-gateway pattern
2026-10-12 Add HALMET-ESP32-SignalK-gateway reference in README
    Updated project references in the README to include HALMET-ESP32-SignalK-gateway.
2026-11-07 Release v1.2.3: sync shared espnow_protocol.h (HALMET_OIL_DELTA)
    Adds message type 10 HALMET_OIL_DELTA and the HALMETOilDelta payload struct,
    copied byte-identically from the fleet-wide header. Wire format and firmware
    logic of this gateway unchanged.
2026-11-09 Release v1.2.4: keep ESP-NOW running and retry WiFi after router outage
    handleWifi() no longer turns the radio off (WiFi.mode(WIFI_OFF)) after a
    failed or timed-out connection attempt. The STA idles in DISCONNECTED with
    the radio on and the channel held at ESPNOW_CHANNEL (6), and retries every
    ~30 s to ~2 min, so ESP-NOW keeps working while the router is down and
    WiFi and SignalK recover without a power cycle. Soft AP moved to channel 6,
    core auto-reconnect disabled.
